JussiKalliola/HolybroX500-Docs/holybro-x500-v2/cad/X500_prop/Version1/CAD/archive_ab8d35b/x500-kit/README.md

# X500 Kit

A carbon fiber frame drone kit that is suitable for drone developers who want to airborne quickly with a baseline Pixhawk hardware reference.

## Bill of Materials

You have the options to select the Pixhawk 4 or Pixhawk 4 mini kits with telemetry radio in either 915MHz or 433 MHz.

* Pixhawk 4 or Pixhawk 4 mini autopilot
* Power Management PM07
* Pixhawk4 GPS
* Motors – 2216 KV880
* Propeller 1045
* 433MHz Telemetry Radio / 915MHz Telemetry Radio
* Power and Radio Cables
* Battery Straps \(Lithium polymer battery not included\)
* Carbon fiber frame



## Assembly

Assembly is easy with this kit. Follow the [assembly manual](http://www.holybro.com/manual/X500-Kit_AssemblyManual.pdf) below and you are good to go.[X500-Kit_AssemblyManual.pdf](https://wikifactory.com/+holybro/x500-kit/file/X500-Kit_AssemblyManual.pdf)

## Support

Wikifactory: +holybro

Email : productservice@holybro.com

PX4 Slack: \#usergroup\_holybro
