JussiKalliola/HolybroX500-Docs/holybro-x500-v2/img/PDB-img.webp

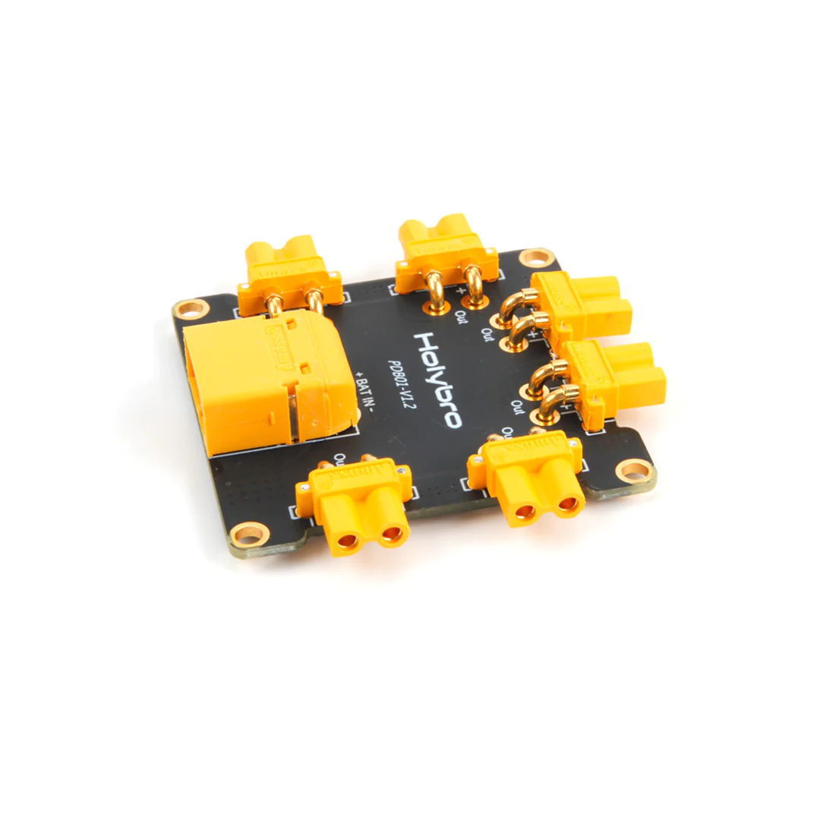
holybro-x500-v2/img/PDB-img.webp
