JussiKalliola/HolybroX500-Docs/holybro-x500-v2/cad/JetNXMount/jetnxmount.stl

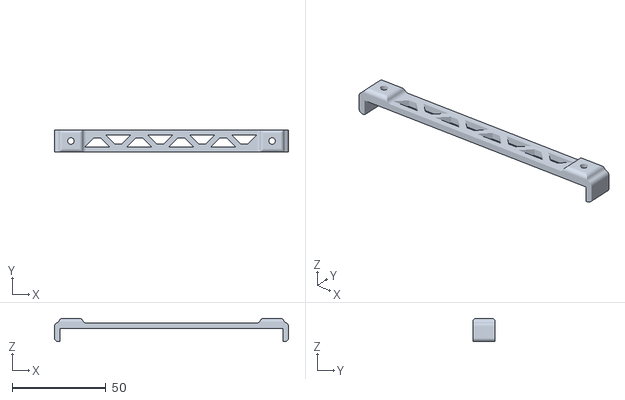
[picture p40: CAD file, 2024-02-23]
holybro-x500-v2/cad/JetNXMount/jetnxmount.stl
125.0 x 12.0 x 12.5
