JussiKalliola/HolybroX500-Docs/holybro-x500-v2/cad/X500_prop/Version2/stls/prop_guard_top.stl

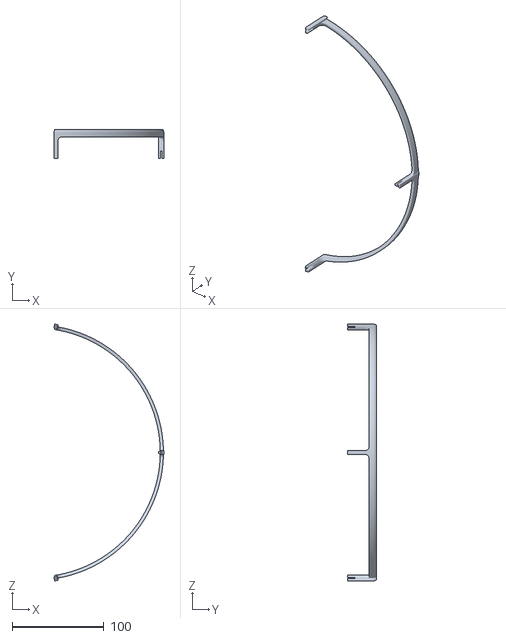
[picture p41: CAD file, 2024-02-23]
holybro-x500-v2/cad/X500_prop/Version2/stls/prop_guard_top.stl
119.9 x 31.7 x 280.4
