JussiKalliola/HolybroX500-Docs/holybro-x500-v2/cad/x9d_phone_stand/Top_Clasp.stl

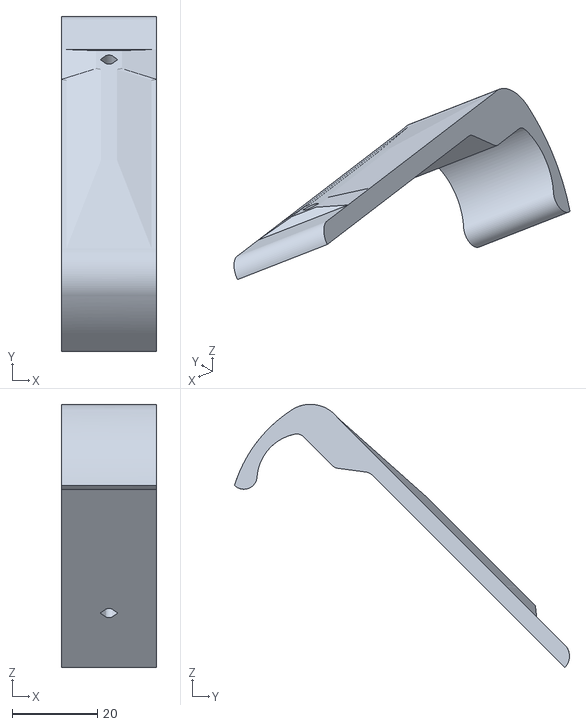
[picture p42: CAD file, 2024-02-23]
holybro-x500-v2/cad/x9d_phone_stand/Top_Clasp.stl
22.4 x 78.6 x 61.8
