JussiKalliola/HolybroX500-Docs/holybro-x500-v2/cad/X500_prop/Version2/stls/prop_guard_bottom.stl

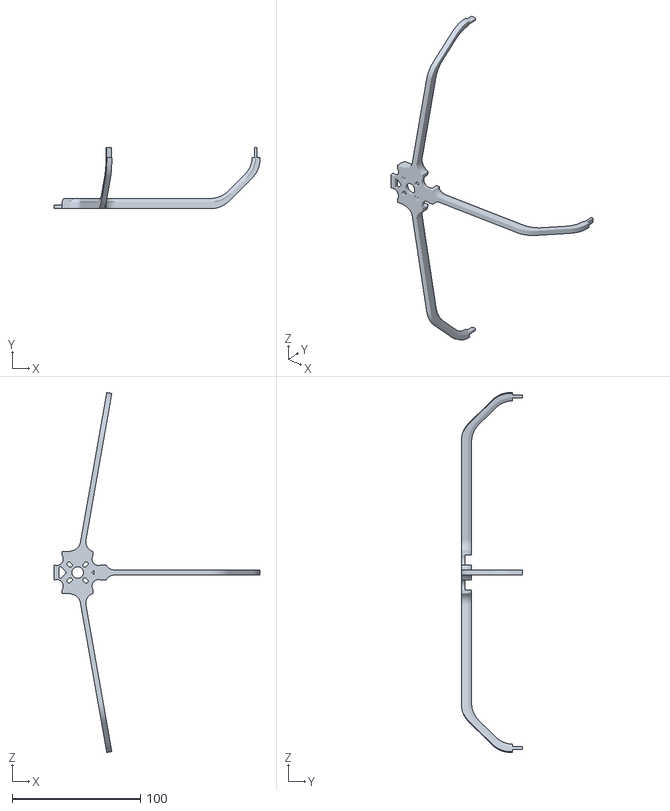
[picture p43: CAD file, 2024-02-23]
holybro-x500-v2/cad/X500_prop/Version2/stls/prop_guard_bottom.stl
160.4 x 47.8 x 280.4
