JussiKalliola/HolybroX500-Docs/holybro-x500-v2/cad/x9d_phone_stand/d455_mount_f.stl

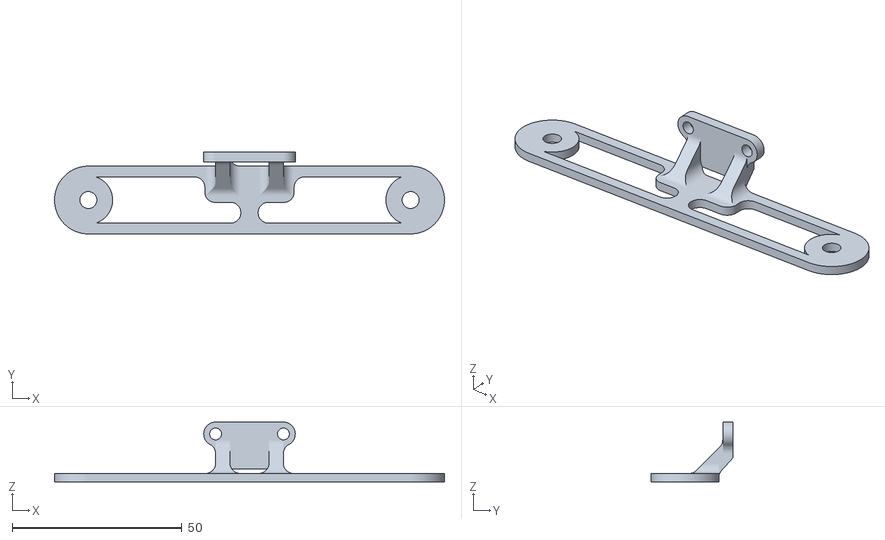
[picture p44: CAD file, 2024-02-23]
holybro-x500-v2/cad/x9d_phone_stand/d455_mount_f.stl
115.0 x 24.1 x 17.6
