JussiKalliola/HolybroX500-Docs/holybro-x500-v2/cad/x9d_phone_stand/Bracket.stl

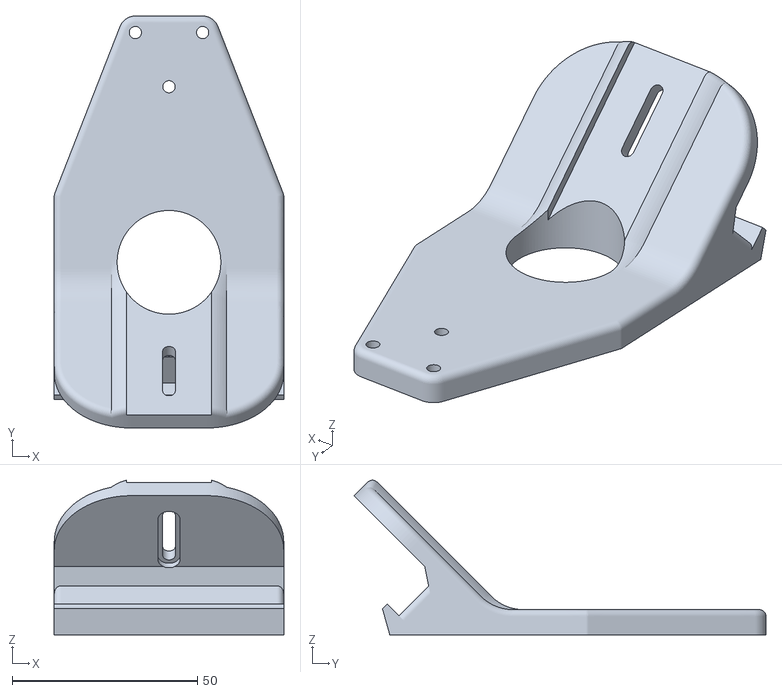
[picture p45: CAD file, 2024-02-23]
holybro-x500-v2/cad/x9d_phone_stand/Bracket.stl
62.0 x 111.3 x 41.8
