JussiKalliola/HolybroX500-Docs/holybro-x500-v2/cad/x9d_phone_stand/Bar_Mount_Block.stl

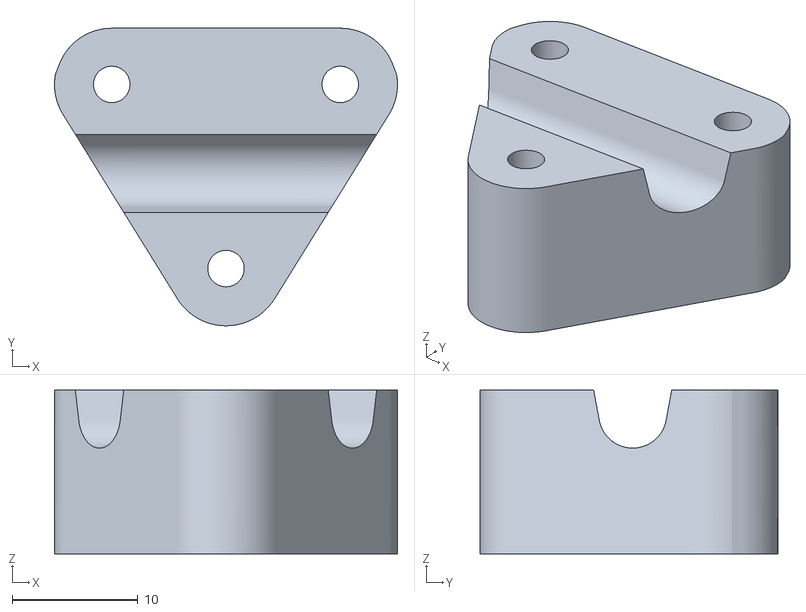
[picture p46: CAD file, 2024-02-23]
holybro-x500-v2/cad/x9d_phone_stand/Bar_Mount_Block.stl
27.3 x 23.6 x 13.0
