JussiKalliola/HolybroX500-Docs/holybro-x500-v2/cad/X500_prop/Version2/stls/captive_nut.stl

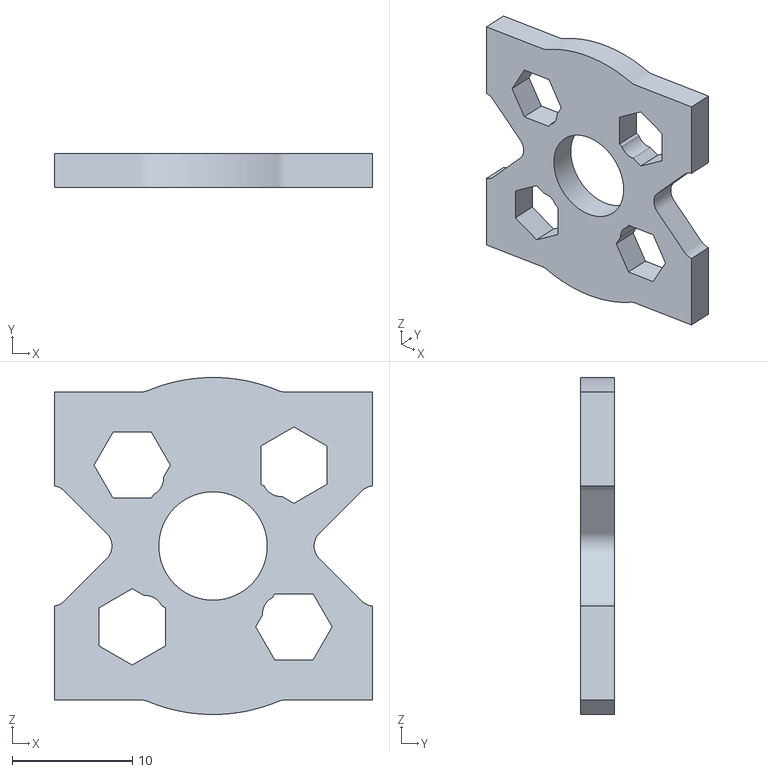
[picture p47: CAD file, 2024-02-23]
holybro-x500-v2/cad/X500_prop/Version2/stls/captive_nut.stl
26.4 x 2.80 x 28.0
