JussiKalliola/HolybroX500-Docs/holybro-x500-v2/cad/X500_prop/Version1/CAD/archive_ab8d35b/x500-kit/Frame Models/STP/hanger_asm.stp

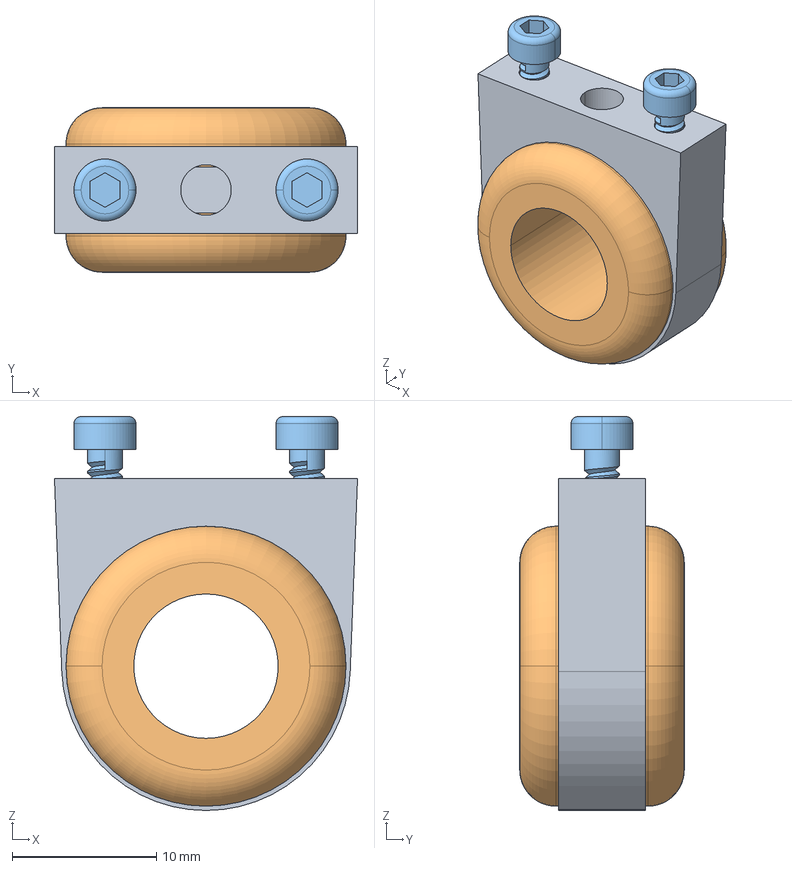
[picture p49: CAD file, 2024-02-23, an earlier design]
holybro-x500-v2/cad/X500_prop/Version1/CAD/archive_ab8d35b/x500-kit/Frame Models/STP/hanger_asm.stp
21.0 x 11.4 x 27.3 mm
JIA-GUAN
HUAN-GUIJIAO
GB70-M2-5-11-DING x 2
