JussiKalliola/HolybroX500-Docs/holybro-x500-v2/cad/X500_prop/Version1/CAD/archive_ab8d35b/x500-kit/Frame Models/STP/landing-gear-x500_asm.stp

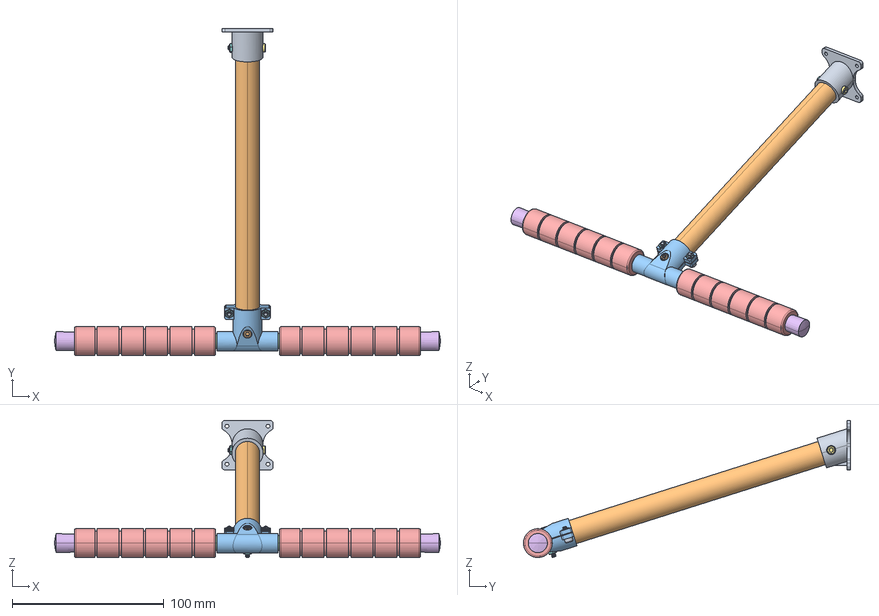
[picture p50: CAD file, 2024-02-23, an earlier design]
holybro-x500-v2/cad/X500_prop/Version1/CAD/archive_ab8d35b/x500-kit/Frame Models/STP/landing-gear-x500_asm.stp
254.0 x 215.3 x 90.2 mm
JIA-LIANJIE
GUAN-CHENG
JIAO-LIANJIE
GUAN-JIAO
JIAO-EVA x 2
MAO-JIAO x 2
GB70-M3-25-DING
LM-M3-DING x 4
GB70-M3-8-DING x 2
GB70-M3-21-DING
