JussiKalliola/HolybroX500-Docs/holybro-x500-v2/cad/X500_prop/Version1/CAD/archive_ab8d35b/x500-kit/Frame Models/STP/pylons-X500.stp

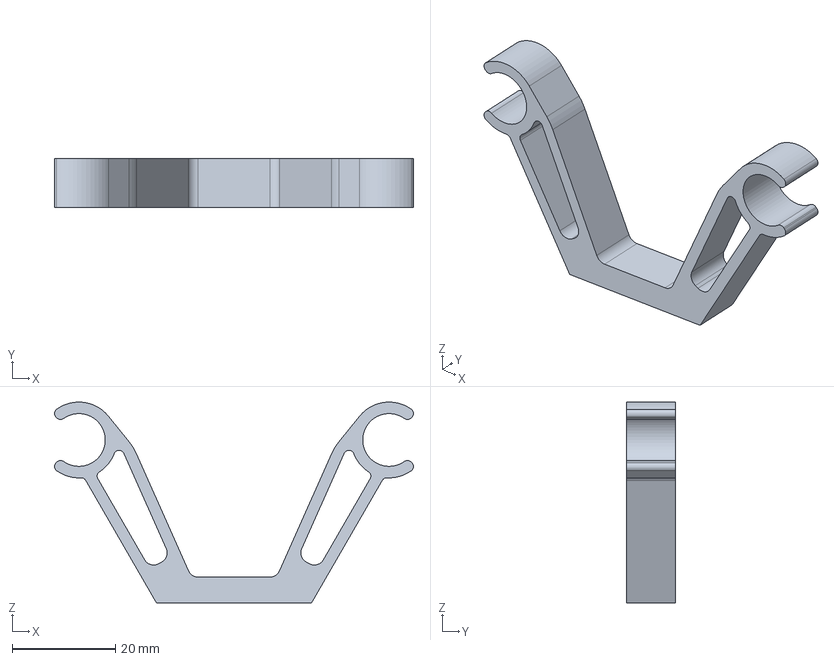
[picture p51: CAD file, 2024-02-23, an earlier design]
holybro-x500-v2/cad/X500_prop/Version1/CAD/archive_ab8d35b/x500-kit/Frame Models/STP/pylons-X500.stp
69.4 x 9.50 x 38.8 mm
