JussiKalliola/HolybroX500-Docs/holybro-x500-v2/cad/X500_prop/Version1/STL/prop_gurd_l.stl

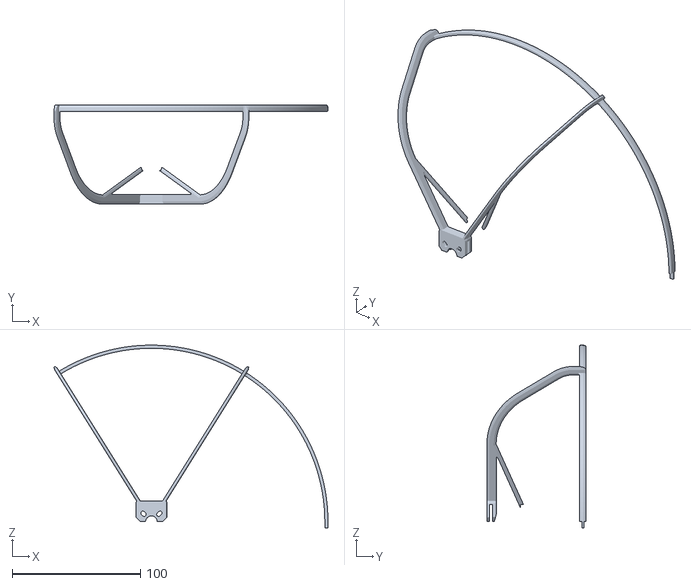
[picture p52: CAD file, 2024-02-23, an earlier design]
holybro-x500-v2/cad/X500_prop/Version1/STL/prop_gurd_l.stl
213.4 x 77.3 x 142.4
