JussiKalliola/HolybroX500-Docs/holybro-x500-v2/cad/X500_prop/Version1/CAD/archive_ab8d35b/x500-kit/Frame Models/STP/Battery-mounting-plat.stp

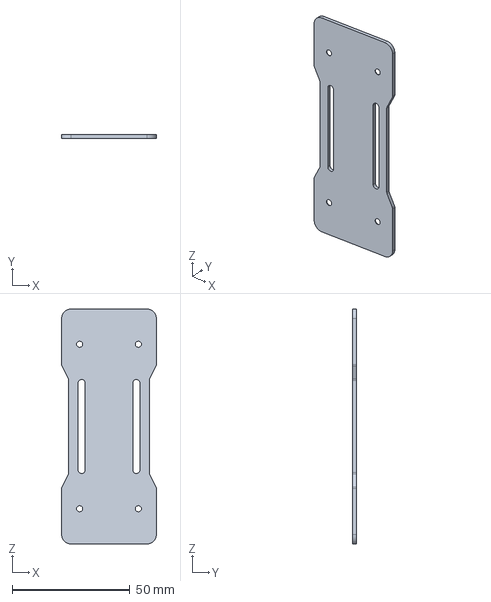
[picture p53: CAD file, 2024-02-23, an earlier design]
holybro-x500-v2/cad/X500_prop/Version1/CAD/archive_ab8d35b/x500-kit/Frame Models/STP/Battery-mounting-plat.stp
40.3 x 1.50 x 100.0 mm
