JussiKalliola/HolybroX500-Docs/holybro-x500-v2/cad/X500_prop/Version1/STL/prop_gurd_l_B.stl

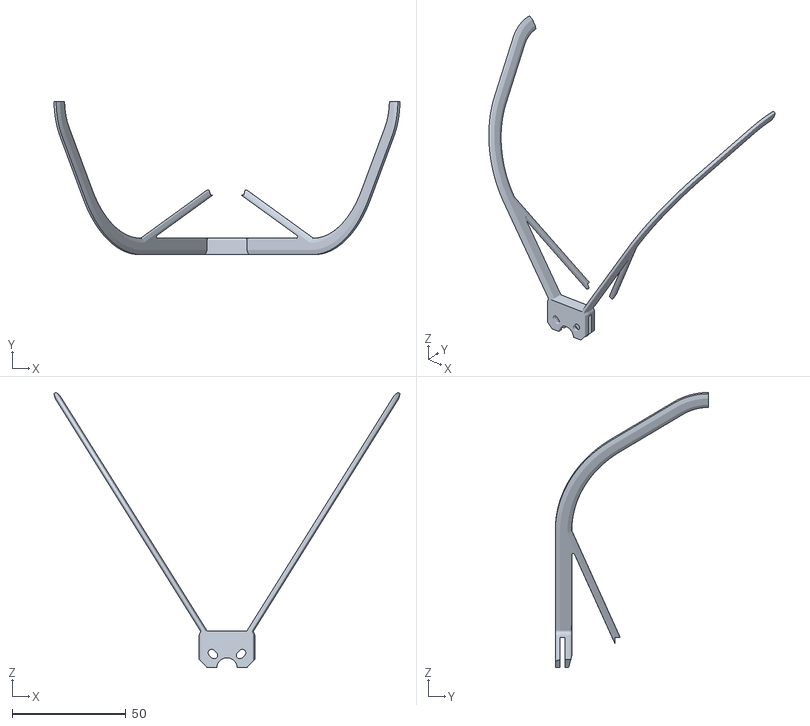
[picture p54: CAD file, 2024-02-23, an earlier design]
holybro-x500-v2/cad/X500_prop/Version1/STL/prop_gurd_l_B.stl
151.8 x 67.3 x 120.8
