JussiKalliola/HolybroX500-Docs/holybro-x500-v2/cad/X500_prop/Version1/STL/prop_gurd_sup.stl

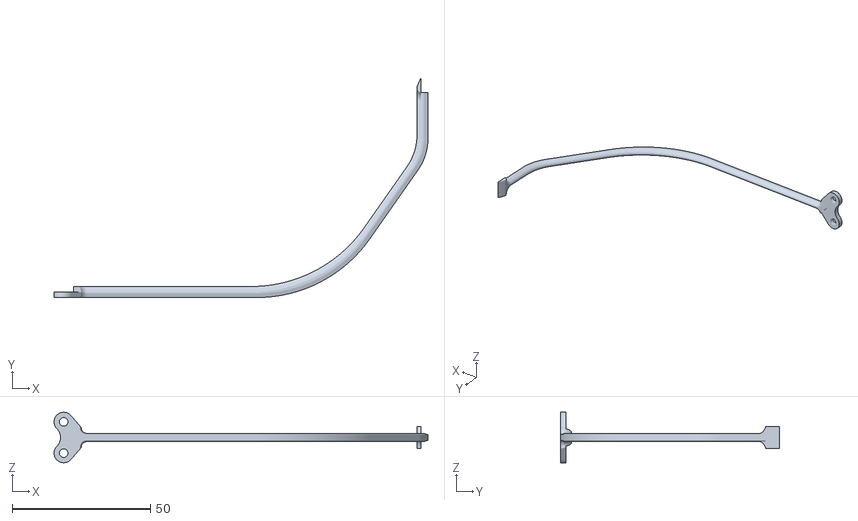
[picture p55: CAD file, 2024-02-23, an earlier design]
holybro-x500-v2/cad/X500_prop/Version1/STL/prop_gurd_sup.stl
135.4 x 79.3 x 18.3
