JussiKalliola/HolybroX500-Docs/(list of files, cad)

Other CAD files:
holybro-x500-v2/cad/X500_prop/Version1/STL/prop_gurd_r_B.stl
holybro-x500-v2/cad/D455mount/OldVersions/d455_t265_mount_f.0001.ipt
holybro-x500-v2/cad/D455mount/d455_mount_f.ipt
holybro-x500-v2/cad/D455mount/d455_prt.ipt
holybro-x500-v2/cad/D455mount/d455_t265_mount_f.ipt
holybro-x500-v2/cad/JetNXMount/jetnxmount.ipt
holybro-x500-v2/cad/X500_prop/Version1/CAD/archive_ab8d35b/x500-kit/Frame Models/BAN-DJ.ipt
holybro-x500-v2/cad/X500_prop/Version1/CAD/archive_ab8d35b/x500-kit/Frame Models/CAD/Arm/OldVersions/arm-asm.0002.iam
holybro-x500-v2/cad/X500_prop/Version1/CAD/archive_ab8d35b/x500-kit/Frame Models/CAD/Arm/arm-asm.iam
holybro-x500-v2/cad/X500_prop/Version1/CAD/archive_ab8d35b/x500-kit/Frame Models/GUAN-JIBI.ipt
holybro-x500-v2/cad/X500_prop/Version1/CAD/archive_ab8d35b/x500-kit/Frame Models/JIBI-JIA.ipt
holybro-x500-v2/cad/X500_prop/Version1/CAD/archive_ab8d35b/x500-kit/Frame Models/M3-30-PAN-DING.ipt
holybro-x500-v2/cad/X500_prop/Version1/CAD/archive_ab8d35b/x500-kit/Frame Models/OldVersions/BAN-DJ.0001.ipt
holybro-x500-v2/cad/X500_prop/Version1/CAD/archive_ab8d35b/x500-kit/Frame Models/STP/PAN-TILT-platform-plat.stp
holybro-x500-v2/cad/X500_prop/Version1/CAD/archive_ab8d35b/x500-kit/Frame Models/STP/battery-pad.stp
holybro-x500-v2/cad/X500_prop/Version1/CAD/archive_ab8d35b/x500-kit/Frame Models/STP/bottom-plat-X500.stp
holybro-x500-v2/cad/X500_prop/Version1/CAD/archive_ab8d35b/x500-kit/Frame Models/STP/carbon fiber tube.stp
holybro-x500-v2/cad/X500_prop/Version1/CAD/archive_ab8d35b/x500-kit/Frame Models/STP/dj-2216-kv880.stp
holybro-x500-v2/cad/X500_prop/Version1/CAD/archive_ab8d35b/x500-kit/Frame Models/STP/nylon-nut-m3.stp
holybro-x500-v2/cad/X500_prop/Version1/CAD/archive_ab8d35b/x500-kit/Frame Models/STP/nylon-stud-m3x6-6.stp
holybro-x500-v2/cad/X500_prop/Version1/CAD/archive_ab8d35b/x500-kit/Frame Models/STP/top-plat-X500.stp
holybro-x500-v2/cad/X500_prop/Version1/CAD/archive_ab8d35b/x500-kit/Frame Models/ZSLM-M3-DING.ipt
holybro-x500-v2/cad/X500_prop/Version1/CAD/prop_gurd_l.ipt
holybro-x500-v2/cad/X500_prop/Version1/CAD/prop_gurd_r.ipt
holybro-x500-v2/cad/X500_prop/Version1/STL/prop_gurd_l_T.stl
holybro-x500-v2/cad/X500_prop/Version1/STL/prop_gurd_r.stl
holybro-x500-v2/cad/X500_prop/Version1/STL/prop_gurd_r_T.stl
holybro-x500-v2/cad/X500_prop/Version2/Arm.iam
holybro-x500-v2/cad/X500_prop/Version2/OldVersions/Arm.0002.iam
holybro-x500-v2/cad/X500_prop/Version2/motor_with_prop.ipt
