JussiKalliola/HolybroX500-Docs/holybro-x500-v2/docs/Holybro_X500_V2_Frame_Kit_Assembly_Guide_en.pdf

1

# X500 v2 Assembly Guide

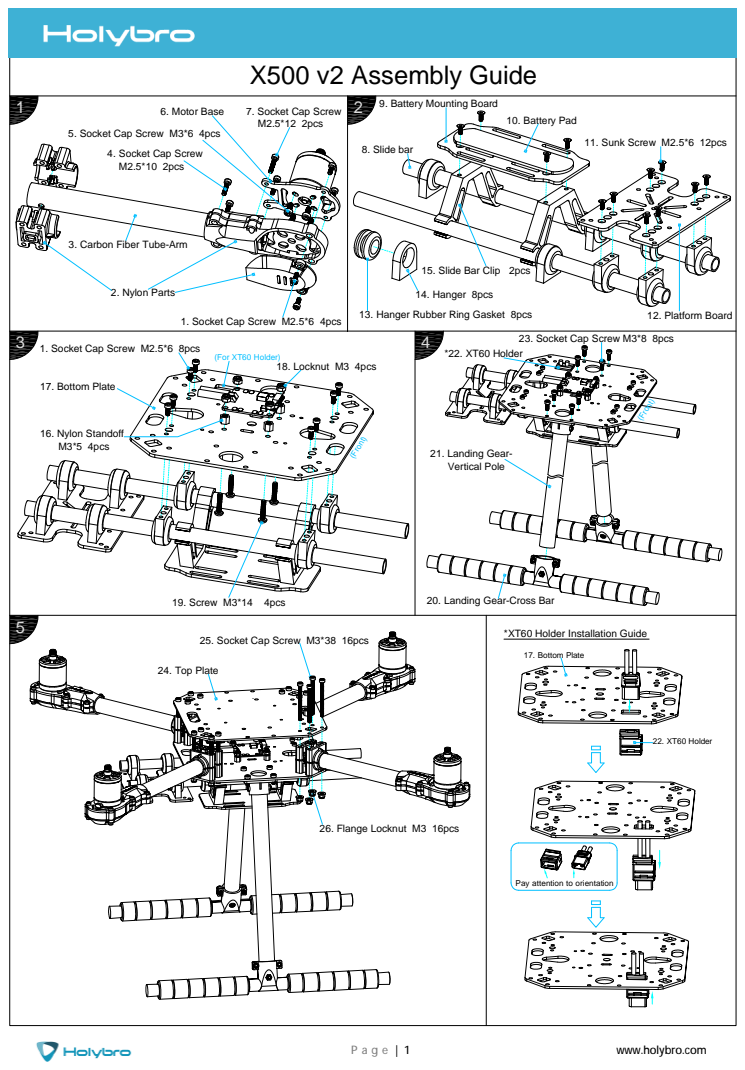
[picture p64: page 1]
*XT60 Holder Installation Guide; 6. Motor Base; 7. Socket Cap Screw; M2.5*12 2pcs; 2. Nylon Parts; 10. Battery Pad; 11. Sunk Screw M2.5*6 12pcs; 14. Hanger 8pcs; 8. Slide bar; 12. Platform Board; 18. Locknut M3 4pcs; 16. Nylon Standoff M3*5 4pcs; 19. Screw M3*14 4pcs; 17. Bottom Plate; 21. Landing Gear- Vertical Pole; 24. Top Plate; *22. XT60 Holder; 26. Flange Locknut M3 16pcs; (Front); (For XT60 Holder); 22. XT60 Holder; www.holybro.com

9. Battery Mounting Board

5. Socket Cap Screw M3*6 4pcs

4. Socket Cap Screw
M2.5*10 2pcs

3. Carbon Fiber Tube-Arm

15. Slide Bar Clip 2pcs

13. Hanger Rubber Ring Gasket 8pcs

1. Socket Cap Screw M2.5*6 4pcs

1. Socket Cap Screw M2.5*6 8pcs

23. Socket Cap Screw M3*8 8pcs

20. Landing Gear-Cross Bar

25. Socket Cap Screw M3*38 16pcs

Pay attention to orientation

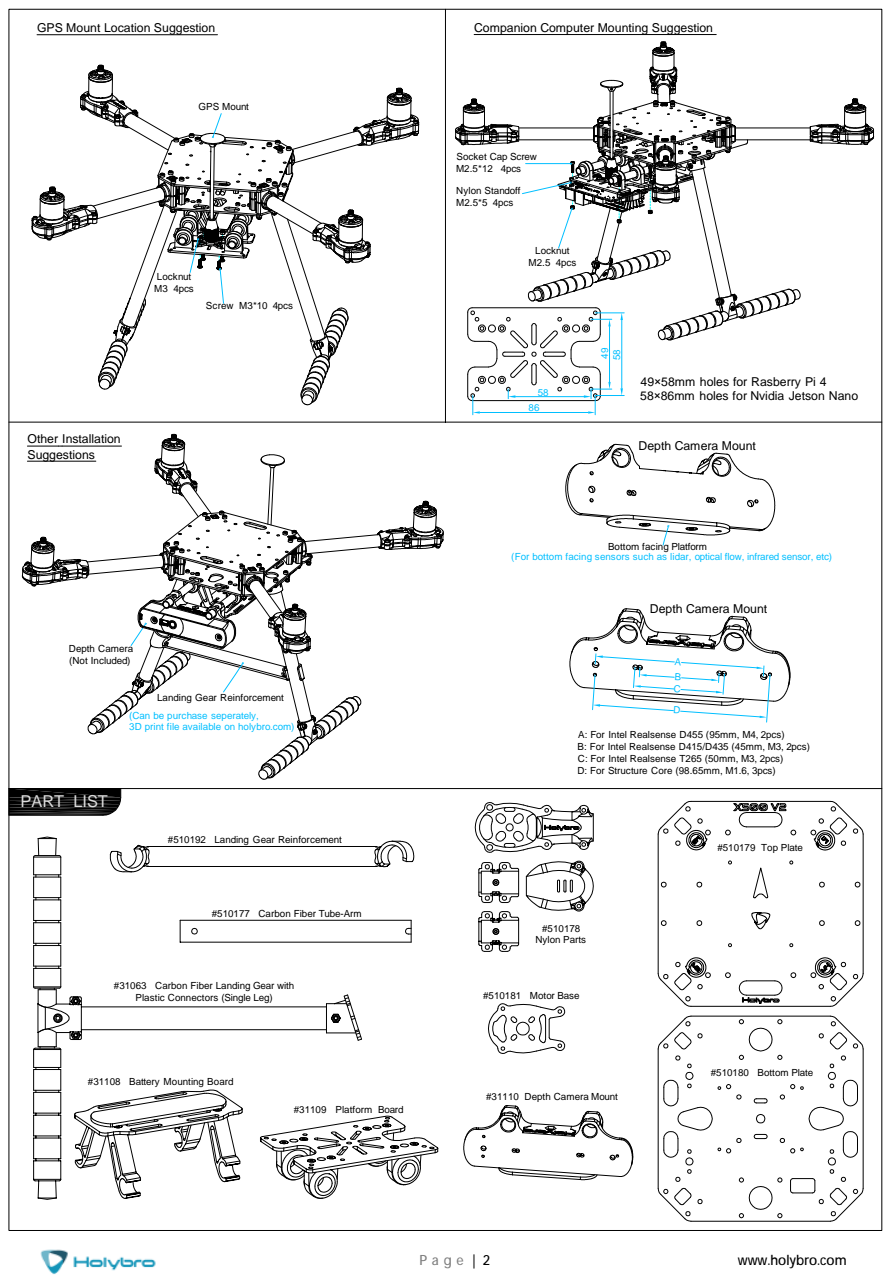
[picture p65: page 2]
Other Installation Suggestions; PART LIST; Depth Camera (Not Included); Screw M3*10 4pcs; Locknut M3 4pcs; GPS Mount; Locknut M2.5 4pcs; Nylon Standoff M2.5*5 4pcs; #510180 Bottom Plate; #510179 Top Plate; #510181 Motor Base; #510178 Nylon Parts; #31109 Platform Board; www.holybro.com

GPS Mount Location Suggestion

Companion Computer Mounting Suggestion

Socket Cap Screw
M2.5*12 4pcs

49×58mm holes for Rasberry Pi 4
58×86mm holes for Nvidia Jetson Nano

Depth Camera Mount

Bottom facing Platform

(For bottom facing sensors such as lidar, optical flow, infrared sensor, etc)

Landing Gear Reinforcement
(Can be purchase seperately,
3D print file available on holybro.com)

A: For Intel Realsense D455 (95mm, M4, 2pcs)
B: For Intel Realsense D415/D435 (45mm, M3, 2pcs)
C: For Intel Realsense T265 (50mm, M3, 2pcs)
D: For Structure Core (98.65mm, M1.6, 3pcs)

#510192 Landing Gear Reinforcement

#510177 Carbon Fiber Tube-Arm

#31063 Carbon Fiber Landing Gear with
Plastic Connectors (Single Leg)

#31108 Battery Mounting Board

#31110 Depth Camera Mount
